rivimey/obc-drone-hat/docs/RasPi-RS232-1.png

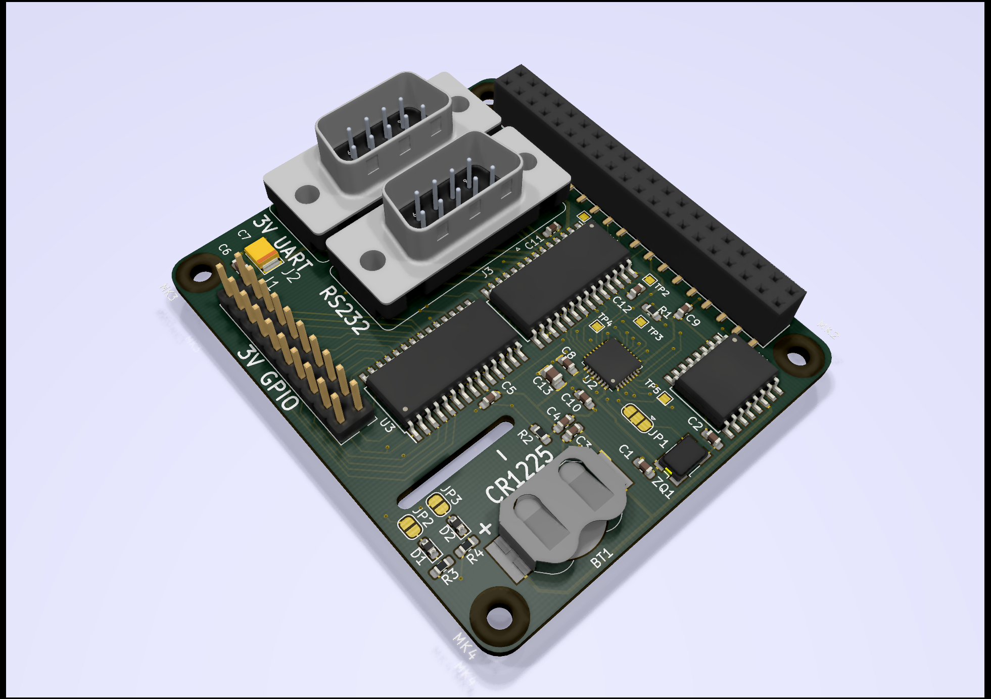
docs/RasPi-RS232-1.png
