rivimey/obc-drone-hat/docs/RasPi-RS232-3.png

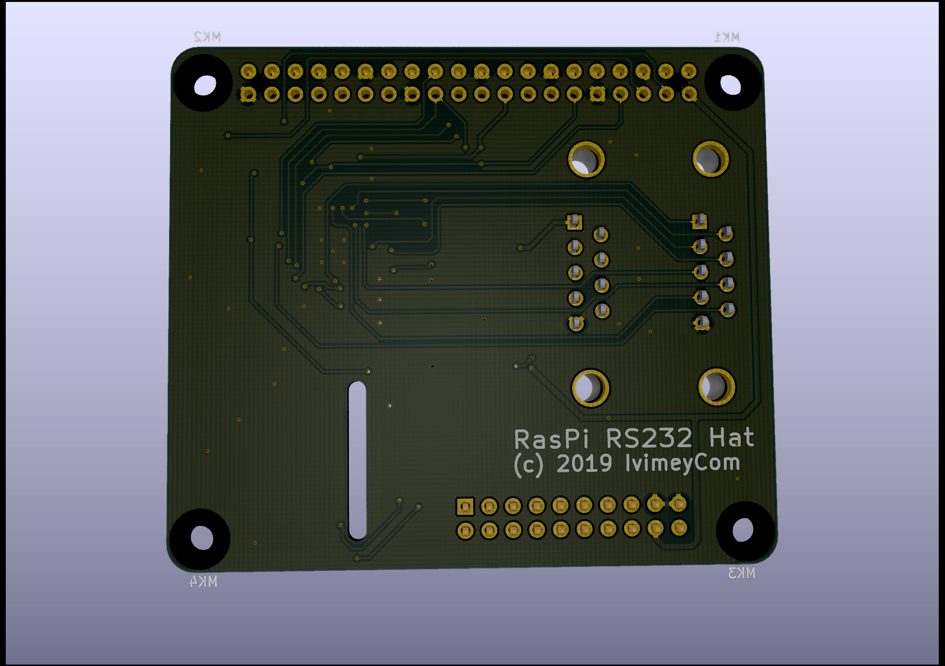
docs/RasPi-RS232-3.png
