rivimey/obc-drone-hat/docs/RasPi-RS232-2.png

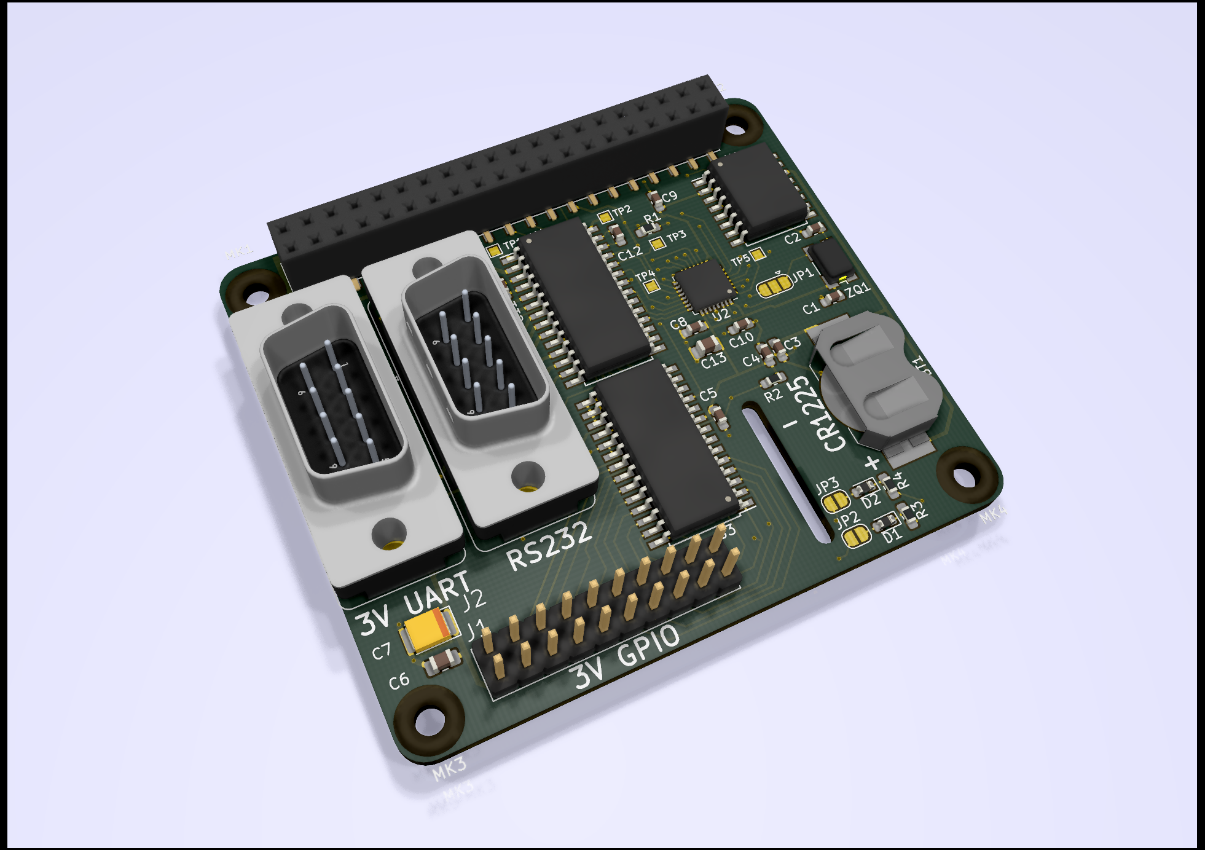
docs/RasPi-RS232-2.png
