rivimey/obc-drone-hat/docs/RasPi-RS232-4.png

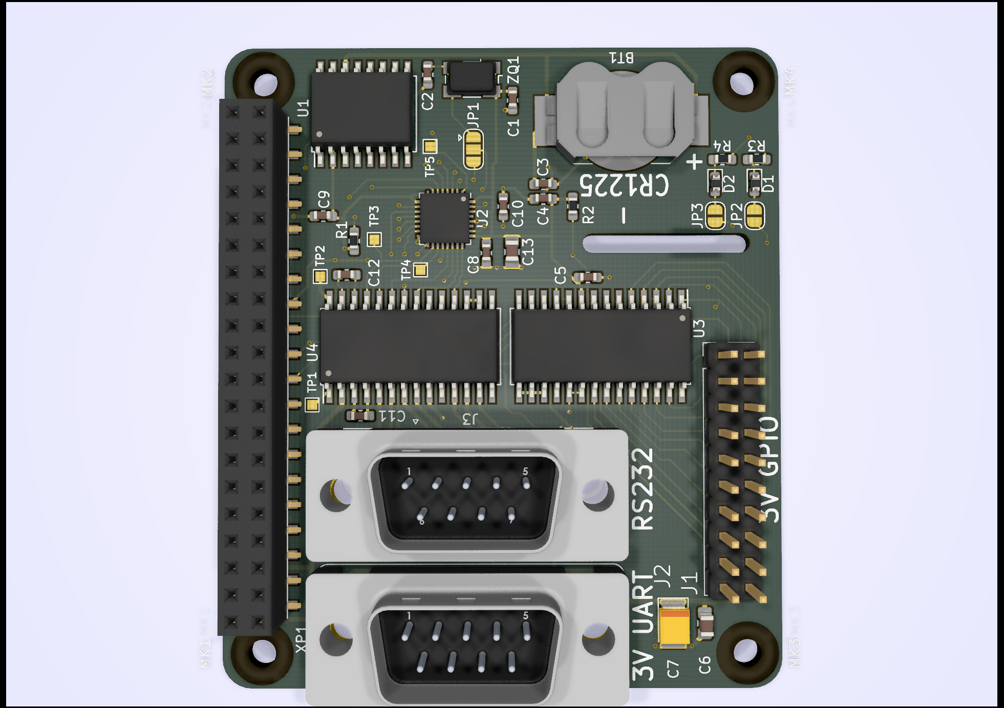
docs/RasPi-RS232-4.png
