rivimey/obc-drone-hat/docs/RaspPiSerial-3D.png

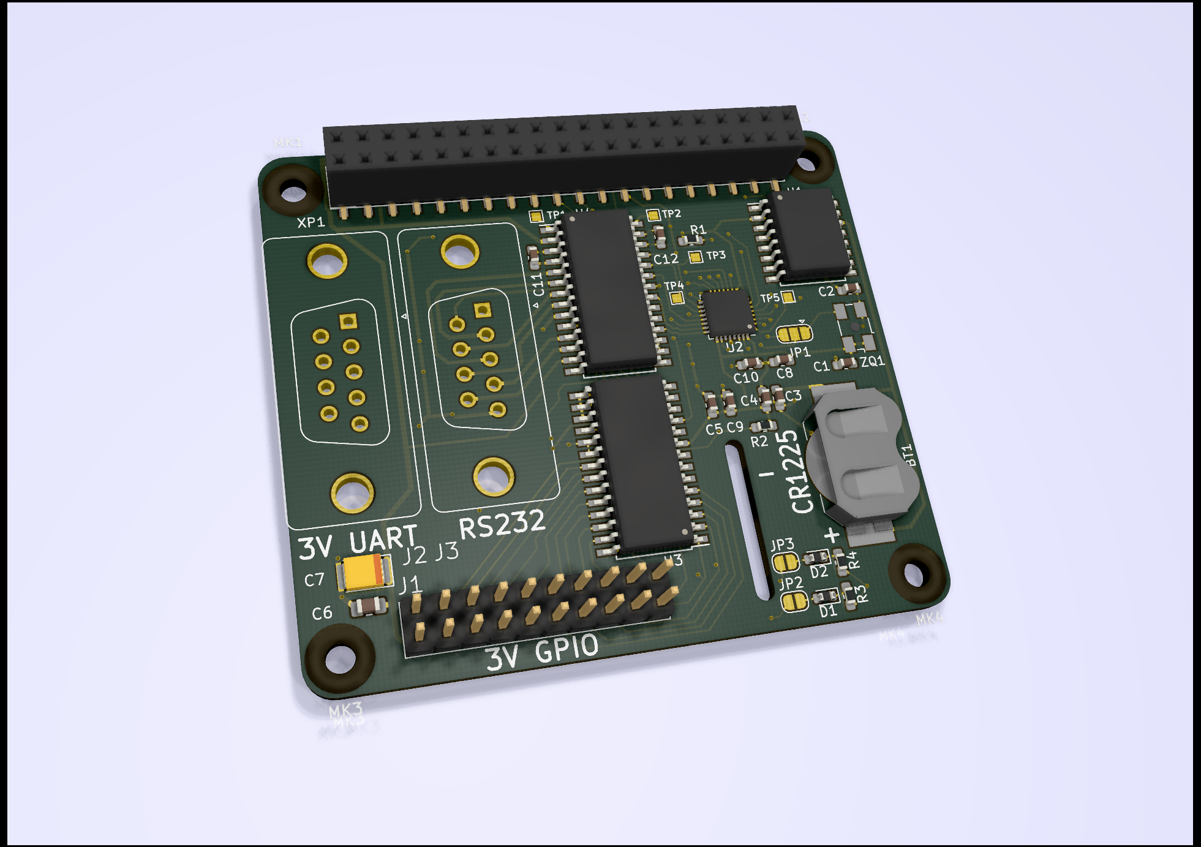
docs/RaspPiSerial-3D.png
