rivimey/obc-drone-hat/hw-v3/raspi232-v3-bottom.png

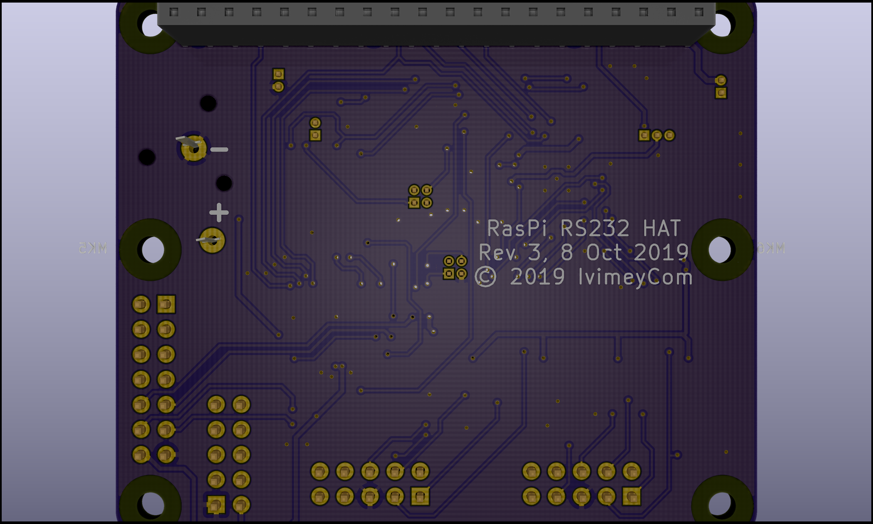
hw-v3/raspi232-v3-bottom.png
