rivimey/obc-drone-hat/hw-v3/raspi232-v3-side1.png

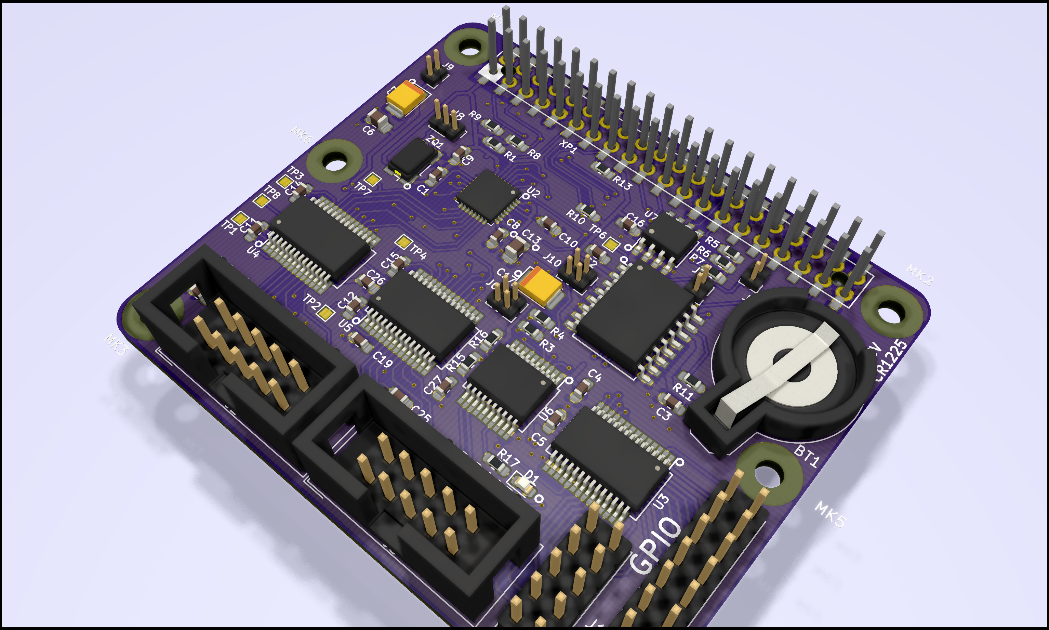
hw-v3/raspi232-v3-side1.png
