rivimey/obc-drone-hat/hw-v3/raspi232-v3-top.png

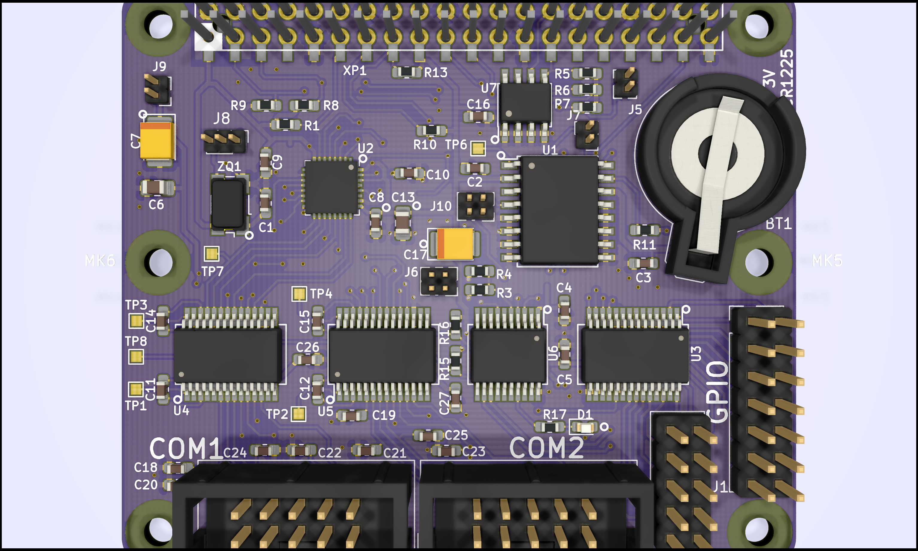
hw-v3/raspi232-v3-top.png
