rivimey/obc-drone-hat/hw-v3/digikey.xlsx

 | Label | Footprint | Datasheet | Part No | Manuf | Order No | Supplier | Unit price | Qty | Line Price | Mouser | Change
BT1 | Battery_Cell | Battery:BatteryHolder_LINX_BAT-HLD-012-SMT | https://www.mouser.co.uk/datasheet/2/238/BAT-HLD-012-SMT%20Diagram-1175215.pdf | BAT-HLD-012-SMT | Linx Technologies | BAT-HLD-012-SMT-ND | Digi-Key | £0.22 | 1 | £0.22 | £0.22 | £0.00
> C6, C13 | 10uF | Capacitor_SMD:C_0805_2012Metric_Pad1.15x1.40mm_HandSolder | https://www.mouser.co.uk/datasheet/2/427/vjw1bcbascomseries-223529.pdf~ | VJ0805G106KXYTW1BC | Vishay / Vitramon | 720-1854-1-ND | Digi-Key | £0.24 | 2 | £0.48 | £0.60 | -£0.12
> C7, C17 | 100uF | Capacitor_Tantalum_SMD:CP_EIA-3528-12_Kemet-T_Pad1.50x2.35mm_HandSolder | https://www.mouser.co.uk/datasheet/2/212/KEM_T2076_T52X-530-1104134.pdf | T520B107M010ATE070 | KEMET | 399-17690-1-ND | Digi-Key | £0.98 | 2 | £1.96 | £2.28 | -£0.32
> C1-C5, C8-C12, C14-C16 | 100nF | Capacitor_SMD:C_0603_1608Metric_Pad1.05x0.95mm_HandSolder | https://www.mouser.co.uk/datasheet/2/212/KEM_C1090_X7R_ESD-1103328.pdf | C0603C104K4RECTU | KEMET | 399-1096-1-ND | Digi-Key | £0.08 | 13 | £1.09 | £1.09 | £0.00
> C18-C25 | 100pF | Capacitor_SMD:C_0603_1608Metric_Pad1.05x0.95mm_HandSolder | https://www.mouser.co.uk/datasheet/2/212/KEM_C1090_X7R_ESD-1103328.pdf | 885012206077 | Wurth Electronics | 732-7995-1-ND | Digi-Key | £0.08 | 8 | £0.64 | £0.28 | £0.36
J1 | Conn_02x07 | Connector_PinHeader_2.54mm:PinHeader_2x07_P2.54mm_Vertical | ~ | 77313-818-14LF | Amphenol FCI | 609-5138-ND | Digi-Key | £0.42 | 1 | £0.42 | £0.48 | -£0.06
> J2, J3 | Conn_02x05_Odd_Even | Connector_IDC:IDC-Header_2x05_P2.54mm_Vertical | ~ | 86130105014345E1LF | Amphenol FCI | 609-6211-ND | Digi-Key | £0.34 | 2 | £0.68 | £0.69 | -£0.01
J4 | Conn_02x04 | Connector_PinHeader_2.54mm:PinHeader_2x04_P2.54mm_Vertical | ~ | 77313-818-08LF | Amphenol FCI | 609-5135-ND | Digi-Key | £0.33 | 1 | £0.33 | £0.37 | -£0.04
> J5-J7 | Conn_01x02 | Connector_PinHeader_1.27mm:PinHeader_1x02_P1.27mm_Vertical | https://www.mouser.co.uk/datasheet/2/181/M50-353-1100851.pdf | M50-3530242 | Harwin | 952-3598-ND | Digi-Key | £0.09 | 3 | £0.27 | £0.25 | £0.02
J8 | Conn_01x03 | Connector_PinHeader_1.27mm:PinHeader_1x03_P1.27mm_Vertical | https://www.mouser.co.uk/datasheet/2/181/M50-353-1100851.pdf | M50-3530342 | Harwin | 952-3599-ND | Digi-Key | £0.10 | 1 | £0.10 | £0.08 | £0.02
> R1, R3, R4, R10 | 10K | Resistor_SMD:R_0603_1608Metric_Pad1.05x0.95mm_HandSolder | ~ | CRCW060310K0JNEAC | Vishay | 541-10KGCT-ND | Digi-Key | £0.07 | 4 | £0.28 | £0.30 | -£0.02
> R5, R6, R8, R9 | 3.9K | Resistor_SMD:R_0603_1608Metric_Pad1.05x0.95mm_HandSolder | ~ | CRCW06033K90JNEA | Vishay | 541-3.9KGCT-ND | Digi-Key | £0.07 | 4 | £0.28 | £0.30 | -£0.02
R7 | 1K | Resistor_SMD:R_0603_1608Metric_Pad1.05x0.95mm_HandSolder | ~ | CRCW06031K00JNEAC | Vishay | 541-3991-6-ND | Digi-Key | £0.07 | 1 | £0.07 | £0.08 | -£0.01
U1 | DS3231 | Package_SO:SOIC-16W_7.5x10.3mm_P1.27mm | https://www.mouser.co.uk/datasheet/2/256/DS3231-1513891.pdf | DS3231S#T&R | Maxim Integrated | DS3231S#T&RCT-ND | Digi-Key | £5.89 | 1 | £5.89 | £6.00 | -£0.11
U2 | MAX3109 | Package_DFN_QFN:QFN-32-1EP_5x5mm_P0.5mm_EP3.45x3.45mm | https://www.mouser.co.uk/datasheet/2/256/MAX3109-1512529.pdf | MAX3109ETJ+ | Maxim Integrated | MAX3109ETJ+-ND | Digi-Key | £5.11 | 1 | £5.11 | £5.21 | -£0.10
U3 | MCP23S17_SS | Package_SO:SSOP-28_5.3x10.2mm_P0.65mm | http://ww1.microchip.com/downloads/en/DeviceDoc/20001952C.pdf | MCP23S17T-E/SS | Microchip Technology | MCP23S17T-E/SSCT-ND | Digi-Key | £1.02 | 1 | £1.02 | £1.03 | -£0.01
> U4, U5 | LT1137ACG | Package_SO:SSOP-28_5.3x10.2mm_P0.65mm | https://www.analog.com/media/en/technical-documentation/data-sheets/1130asfb.pdf | LT1137ACG#PBF | Analog Devices | LT1137ACG#PBF-ND | Digi-Key | £5.95 | 2 | £11.90 | £12.14 | -£0.24
U6 | MCP23009-ESS | Package_SO:SSOP-20_5.3x7.2mm_P0.65mm | http://ww1.microchip.com/downloads/en/devicedoc/20001952c.pdf | MCP23009-E/SS | Microchip Technology | MCP23009-E/SS-ND | Digi-Key | £0.87 | 1 | £0.87 | £0.88 | -£0.01
U7 | CAT24C64 | Package_SO:SOIC-8_3.9x4.9mm_P1.27mm | https://www.mouser.co.uk/datasheet/2/308/CAT24C64-D-106086.pdf | CAT24C64WI-GT3 | ON Semiconductor | CAT24C64WI-GT3CT-ND | Digi-Key | £0.16 | 1 | £0.16 | £0.00 | £0.16
XP1 | Rpi_40PIN | hat:RaspberryPi-40Pin_P2.54mm |  | 1112 | Adafruit | 1528-2203-ND | Digi-Key | £1.46 | 1 | £1.46 | £1.49 | -£0.03
ZQ1 | ASFL1-oscillator | Crystal:Crystal_SMD_Abracon_ABM3B-4Pin_5.0x3.2mm | https://www.mouser.com/ProductDetail/ABRACON/ASFL1-24000MHZ-EC-T | ASFL1-24.000MHZ-EC-T | ABRACON | 300-8252-1-ND | Digi-Key | £0.98 | 1 | £0.98 | £0.94 | £0.04
 |  |  |  |  |  |  |  |  | 52 | 34.213 | 34.722 | -£0.51
