rivimey/obc-drone-hat/hw-v3/mouser.xlsx

 | Footprint | Datasheet | Part No | Manuf | Order No | Supplier | Unit price | Qty | Line Price | Digi-Key | Change | Best Supplier | Unit price
BT1 | Battery:BatteryHolder_LINX_BAT-HLD-012-SMT | https://www.mouser.co.uk/datasheet/2/238/BAT-HLD-012-SMT%20Diagram-1175215.pdf | BAT-HLD-012-SMT | Linx Technologies | 712-BAT-HLD-012-SMT | Mouser | £0.22 | 1 | £0.22 | £0.22 | £0.00 |  |  | £0.22
> C6, C13 | Capacitor_SMD:C_0805_2012Metric_Pad1.15x1.40mm_HandSolder | https://www.mouser.co.uk/datasheet/2/427/vjw1bcbascomseries-223529.pdf~ | VJ0805G106KXYTW1BC | Vishay / Vitramon | 77-VJ805G106KXYTW1BC | Mouser | £0.30 | 2 | £0.60 | £0.48 | £0.12 | digi-key | £0.22 | £0.44
> C7, C17 | Capacitor_Tantalum_SMD:CP_EIA-3528-12_Kemet-T_Pad1.50x2.35mm_HandSolder | https://www.mouser.co.uk/datasheet/2/212/KEM_T2076_T52X-530-1104134.pdf | T520B107M010ATE070 | KEMET | 80-T520B107M10ATE070 | Mouser | £1.14 | 2 | £2.28 | £1.96 | £0.32 | digi-key | £0.98 | £1.96
> C1-C5, C8-C12, C14-C16 | Capacitor_SMD:C_0603_1608Metric_Pad1.05x0.95mm_HandSolder | https://www.mouser.co.uk/datasheet/2/212/KEM_C1090_X7R_ESD-1103328.pdf | C0603C104K4RECTU | KEMET | 80-C0603C104K4RECTU | Mouser | £0.08 | 13 | £1.09 | £1.09 | £0.00 | mouser | £0.04 | £0.47
> C18-C25 | Capacitor_SMD:C_0603_1608Metric_Pad1.05x0.95mm_HandSolder | https://www.mouser.co.uk/datasheet/2/212/KEM_C1090_X7R_ESD-1103328.pdf | 885012206077 | Wurth Electronics | 710-885012206077 | Mouser | £0.04 | 8 | £0.28 | £0.64 | -£0.36 |  |  | £0.28
J1 | Connector_PinHeader_2.54mm:PinHeader_2x07_P2.54mm_Vertical | ~ | 54102-S1007LF | Amphenol FCI | 649-54102-S1007LF | Mouser | £0.48 | 1 | £0.48 | £0.42 | £0.06 |  |  | £0.48
> J2, J3 | Connector_IDC:IDC-Header_2x05_P2.54mm_Vertical | ~ | 86130105014345E1LF | Amphenol FCI | 649-861315014345E1LF | Mouser | £0.34 | 2 | £0.69 | £0.68 | £0.01 |  |  | £0.69
J4 | Connector_PinHeader_2.54mm:PinHeader_2x04_P2.54mm_Vertical | ~ | 10129381-908003BLF | Amphenol FCI | 649-1012938190803BLF | Mouser | £0.37 | 1 | £0.37 | £0.33 | £0.04 |  |  | £0.37
> J5-J7 | Connector_PinHeader_1.27mm:PinHeader_1x02_P1.27mm_Vertical | https://www.mouser.co.uk/datasheet/2/181/M50-353-1100851.pdf | M50-3530242 | Harwin | 855-M50-3530242 | Mouser | £0.08 | 3 | £0.25 | £0.27 | -£0.02 |  |  | £0.25
J8 | Connector_PinHeader_1.27mm:PinHeader_1x03_P1.27mm_Vertical | https://www.mouser.co.uk/datasheet/2/181/M50-353-1100851.pdf | M50-3530242 | Harwin | 855-M50-3530242 | Mouser | £0.08 | 1 | £0.08 | £0.10 | -£0.02 |  |  | £0.08
> R1, R3, R4, R10 | Resistor_SMD:R_0603_1608Metric_Pad1.05x0.95mm_HandSolder | ~ | CRCW060310K0JNEAC | Vishay | 71-CRCW060310K0JNEAC | Mouser | £0.08 | 4 | £0.30 | £0.28 | £0.02 |  |  | £0.30
> R5, R6, R8, R9 | Resistor_SMD:R_0603_1608Metric_Pad1.05x0.95mm_HandSolder | ~ | CRCW06033K90JNEA | Vishay | 71-CRCW06033K90JNEA | Mouser | £0.08 | 4 | £0.30 | £0.28 | £0.02 | e14 | £0.02 | £0.07
R7 | Resistor_SMD:R_0603_1608Metric_Pad1.05x0.95mm_HandSolder | ~ | CRCW06031K00JNEAC | Vishay | 71-CRCW06031K00JNEAC | Mouser | £0.08 | 1 | £0.08 | £0.07 | £0.01 | arrow | £0.02 | £0.02
U1 | Package_SO:SOIC-16W_7.5x10.3mm_P1.27mm | https://www.mouser.co.uk/datasheet/2/256/DS3231-1513891.pdf | DS3231S#T&R | Maxim Integrated | 700-DS3231S#T&R- | Mouser | £6.00 | 1 | £6.00 | £5.89 | £0.11 | e14 a-p | £5.86 | £5.86
U2 | Package_DFN_QFN:QFN-32-1EP_5x5mm_P0.5mm_EP3.45x3.45mm | https://www.mouser.co.uk/datasheet/2/256/MAX3109-1512529.pdf | MAX3109ETJ+ | Maxim Integrated | 700-MAX3109ETJ+ | Mouser | £5.21 | 1 | £5.21 | £5.11 | £0.10 | digi-key | £5.11 | £5.11
U3 | Package_SO:SSOP-28_5.3x10.2mm_P0.65mm | http://ww1.microchip.com/downloads/en/DeviceDoc/20001952C.pdf | MCP23S17T-E/SS | Microchip Technology | 579-MCP23S17T-E/SS | Mouser | £1.03 | 1 | £1.03 | £1.02 | £0.01 | Arrow | £0.99 | £0.99
> U4, U5 | Package_SO:SSOP-28_5.3x10.2mm_P0.65mm | https://www.analog.com/media/en/technical-documentation/data-sheets/1130asfb.pdf | LT1137ACG#PBF | Analog Devices | 584-LT1137ACG#PBF | Mouser | £6.07 | 2 | £12.14 | £11.90 | £0.24 | Mouser | £6.00 | £12.00
U6 | Package_SO:SSOP-20_5.3x7.2mm_P0.65mm | http://ww1.microchip.com/downloads/en/devicedoc/20001952c.pdf | MCP23009-E/SS | Microchip Technology | 579-MCP23009-E/SS | Mouser | £0.88 | 1 | £0.88 | £0.87 | £0.01 | Arrow | £0.77 | £0.77
U7 | Package_SO:SOIC-8_3.9x4.9mm_P1.27mm | https://www.mouser.co.uk/datasheet/2/308/CAT24C64-D-106086.pdf | CAT24C64WI-GT3 | ON Semiconductor | 698-CAT24C64WI-GT3 | Mouser | £0.36 | 1 | £0.36 | £0.16 | £0.20 | Arrow | £0.15 | £0.15
XP1 | hat:RaspberryPi-40Pin_P2.54mm |  | 1112 | Adafruit | 485-1112 | Mouser | £1.49 | 1 | £1.49 | £1.46 | £0.03 |  |  | £1.49
ZQ1 | Crystal:Crystal_SMD_Abracon_ABM3B-4Pin_5.0x3.2mm | https://www.mouser.com/ProductDetail/ABRACON/ASFL1-24000MHZ-EC-T | ASFL1-24.000MHZ-EC-T | ABRACON | 815-ASFL1-24.0-EC-T | Mouser | £0.94 | 1 | £0.94 | £0.98 | -£0.04 |  |  | £0.94
 |  |  |  |  |  |  |  | 52 | 35.0845 | 34.213 | £0.87 |  |  | 32.9467
