rivimey/obc-drone-hat/hw-v3/182-009-113.STEP

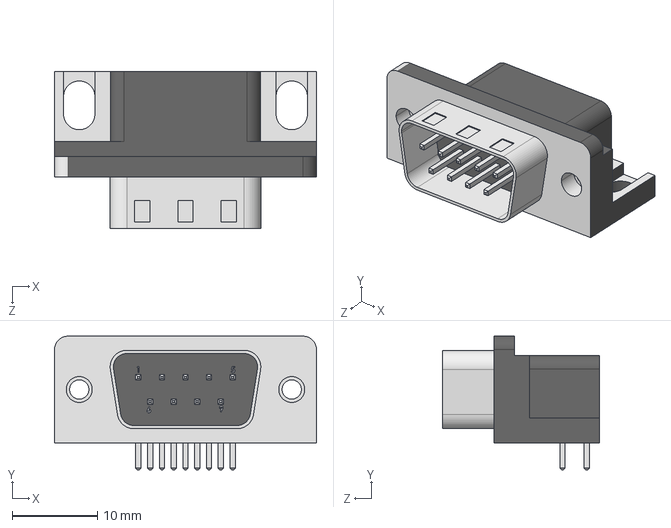
[picture p10: CAD file, 2019-03-01]
hw-v3/182-009-113.STEP
30.8 x 15.7 x 18.5 mm
