rivimey/obc-drone-hat/hw-v3/3ds/REF-182683-02.step

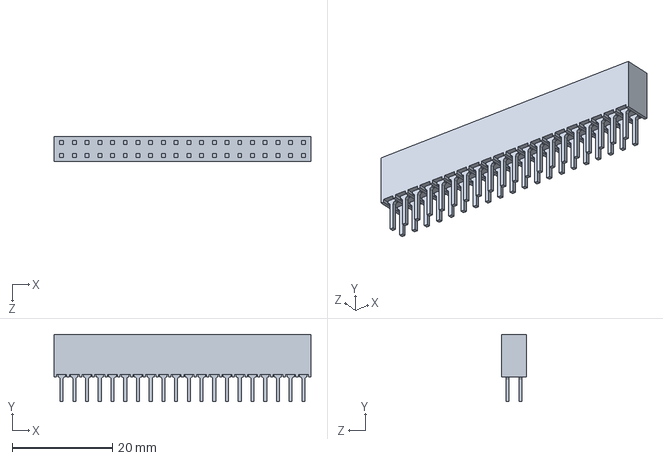
[picture p11: CAD file, 2019-03-28]
hw-v3/3ds/REF-182683-02.step
51.3 x 13.4 x 4.95 mm
