rivimey/obc-drone-hat/hw-v3/189-009-613.STEP

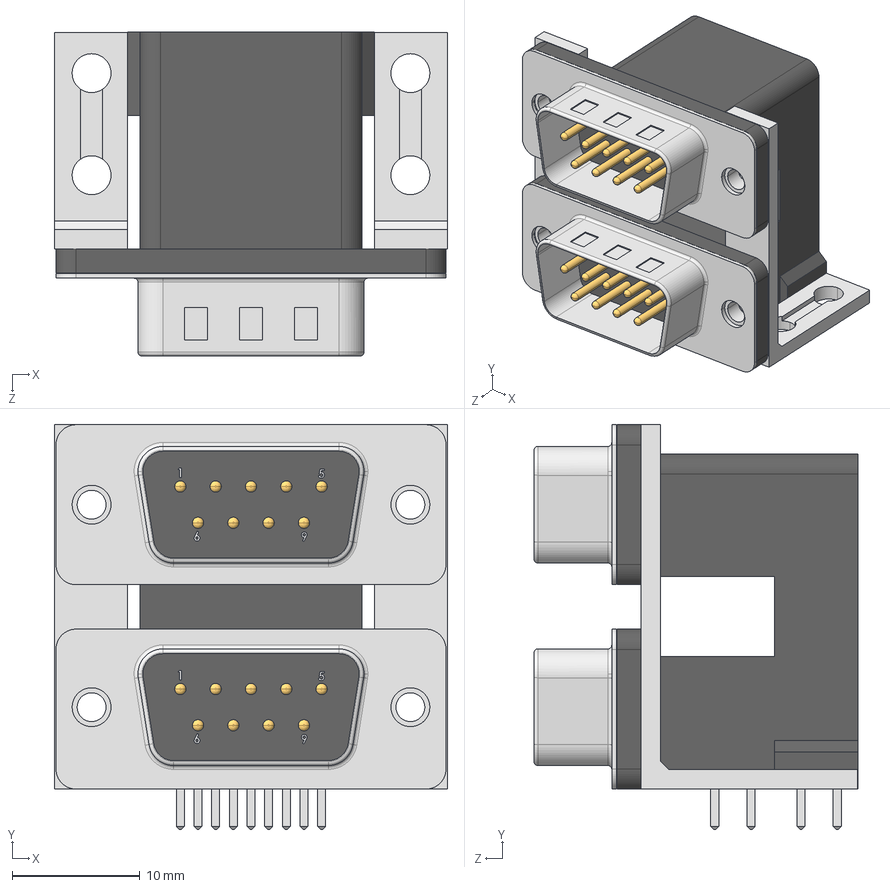
[picture p12: CAD file, 2019-03-01]
hw-v3/189-009-613.STEP
30.8 x 31.8 x 25.4 mm
