rivimey/obc-drone-hat/hw-v3/3ds/REF-182684-02-x.step

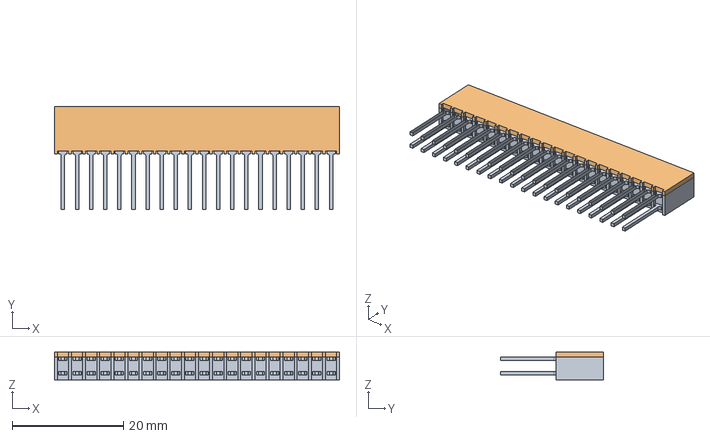
[picture p14: CAD file, 2019-03-28]
hw-v3/3ds/REF-182684-02-x.step
51.3 x 18.5 x 4.95 mm
