rivimey/obc-drone-hat/hw-v3/3ds/191-009-123.STEP

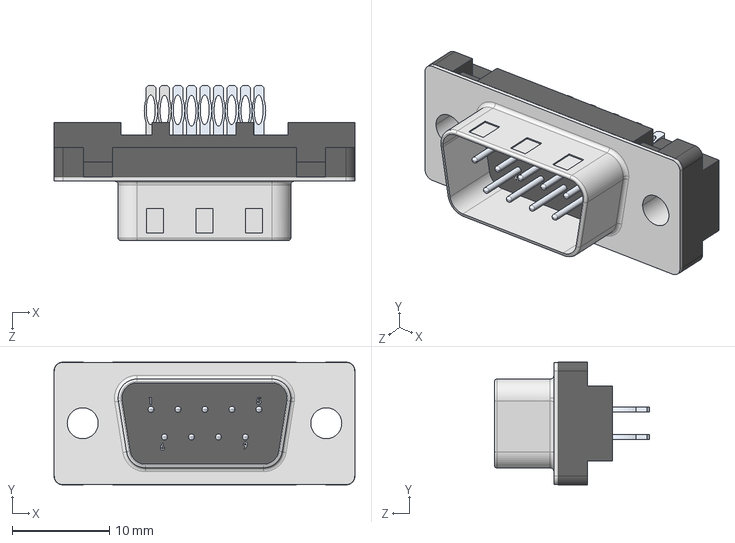
[picture p15: CAD file, 2019-03-01]
hw-v3/3ds/191-009-123.STEP
30.9 x 12.6 x 15.9 mm
