rivimey/obc-drone-hat/(list of files, cad)

Other CAD files:
hw-v3/3ds/191-009-123.IGS
