rivimey/obc-drone-hat/hw-v2/Raspi232-v3.pdf

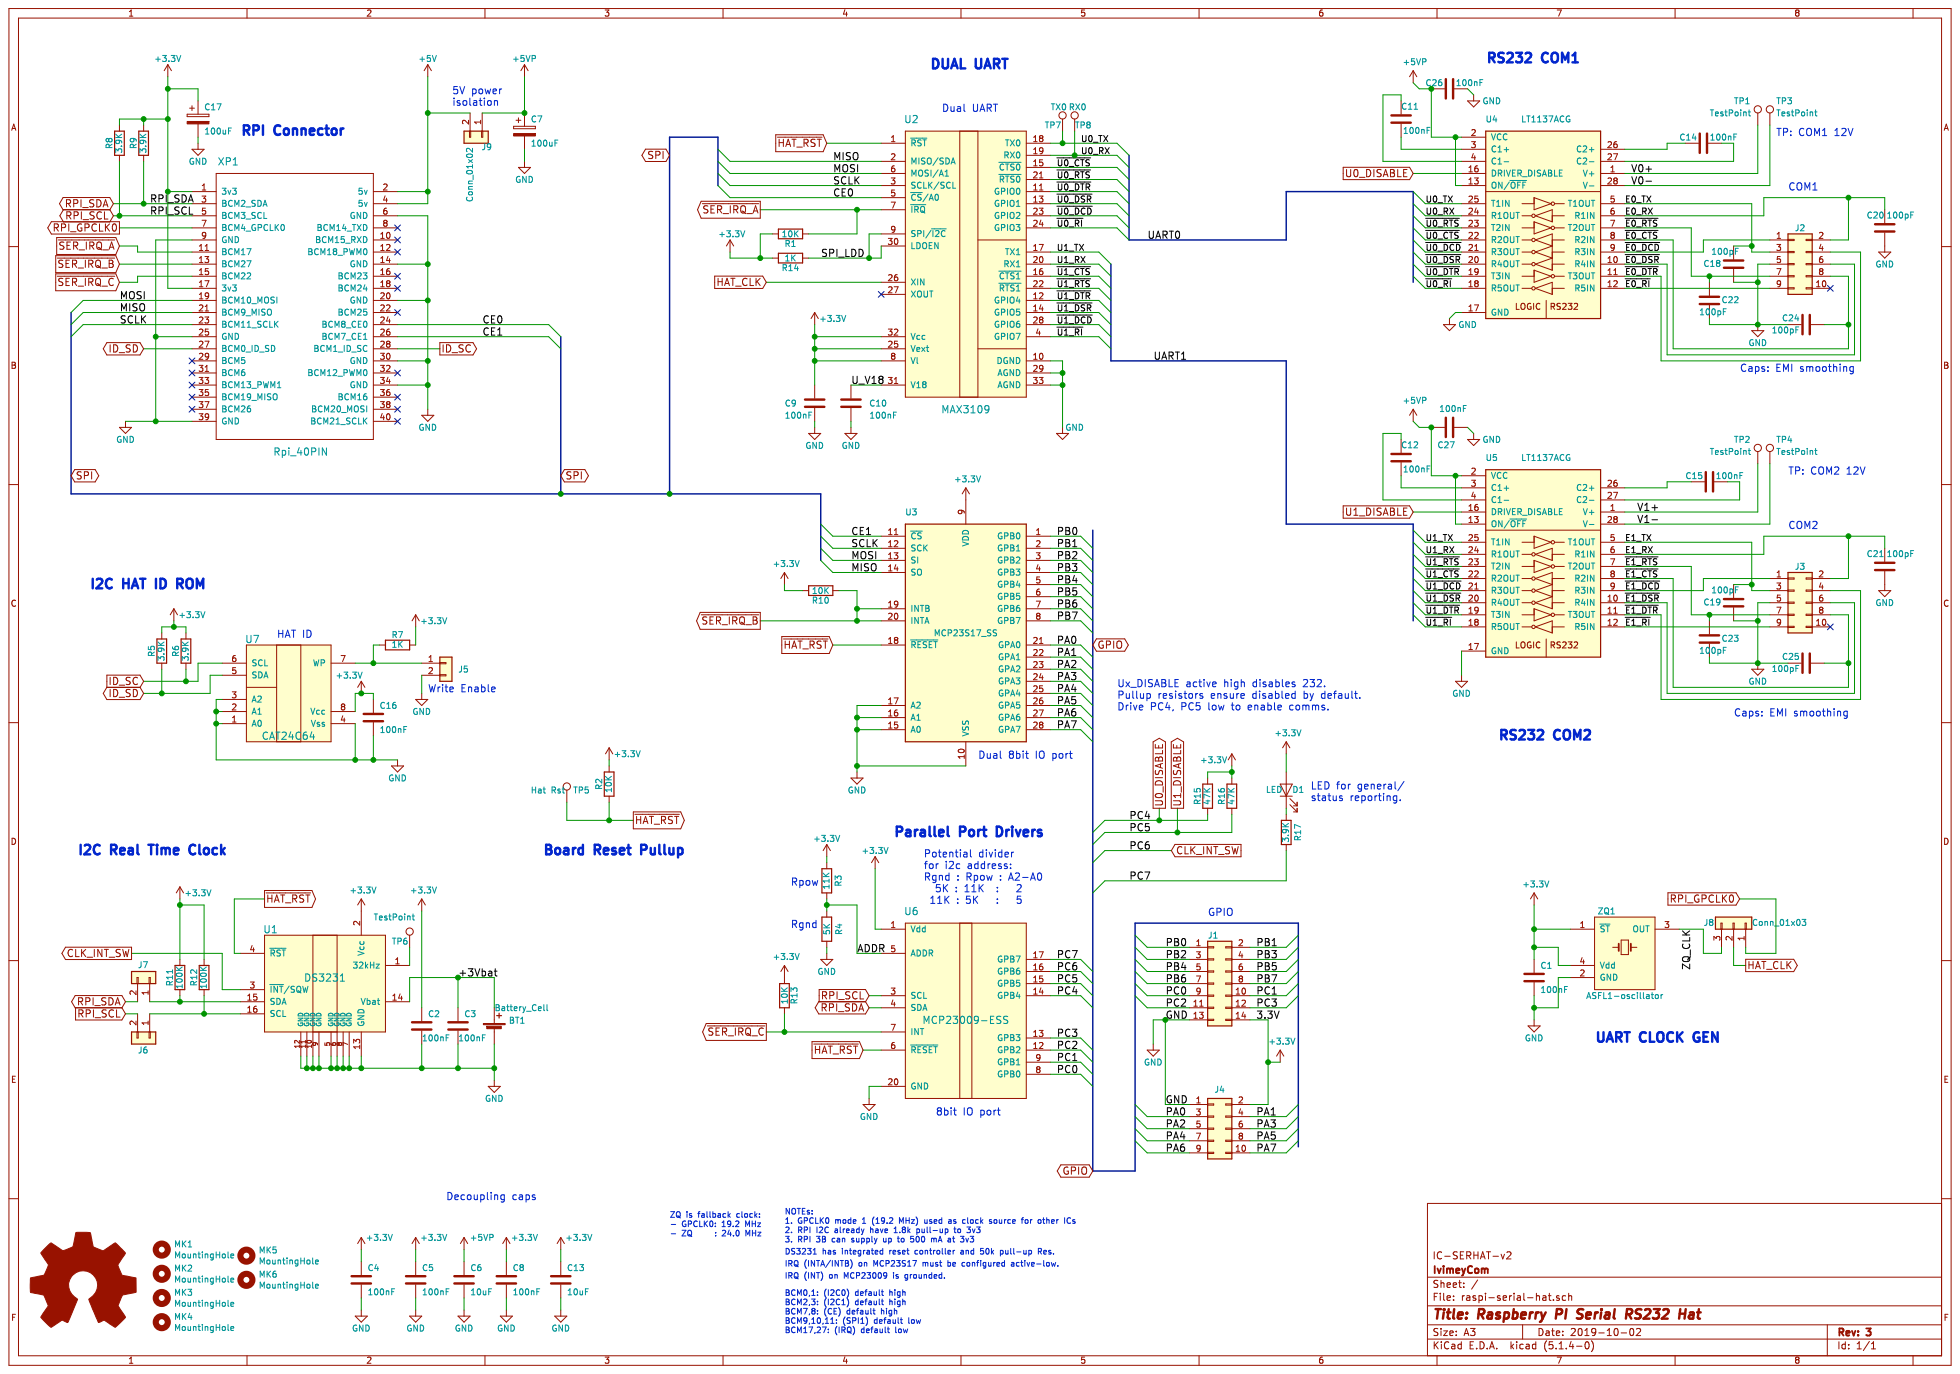
[picture p16: page 1]
