rivimey/obc-drone-hat/hw-v3/raspi-serial-hat.kicad_pcb

## KiCad design hw-v3/raspi-serial-hat.kicad_pcb (2019-11-05)

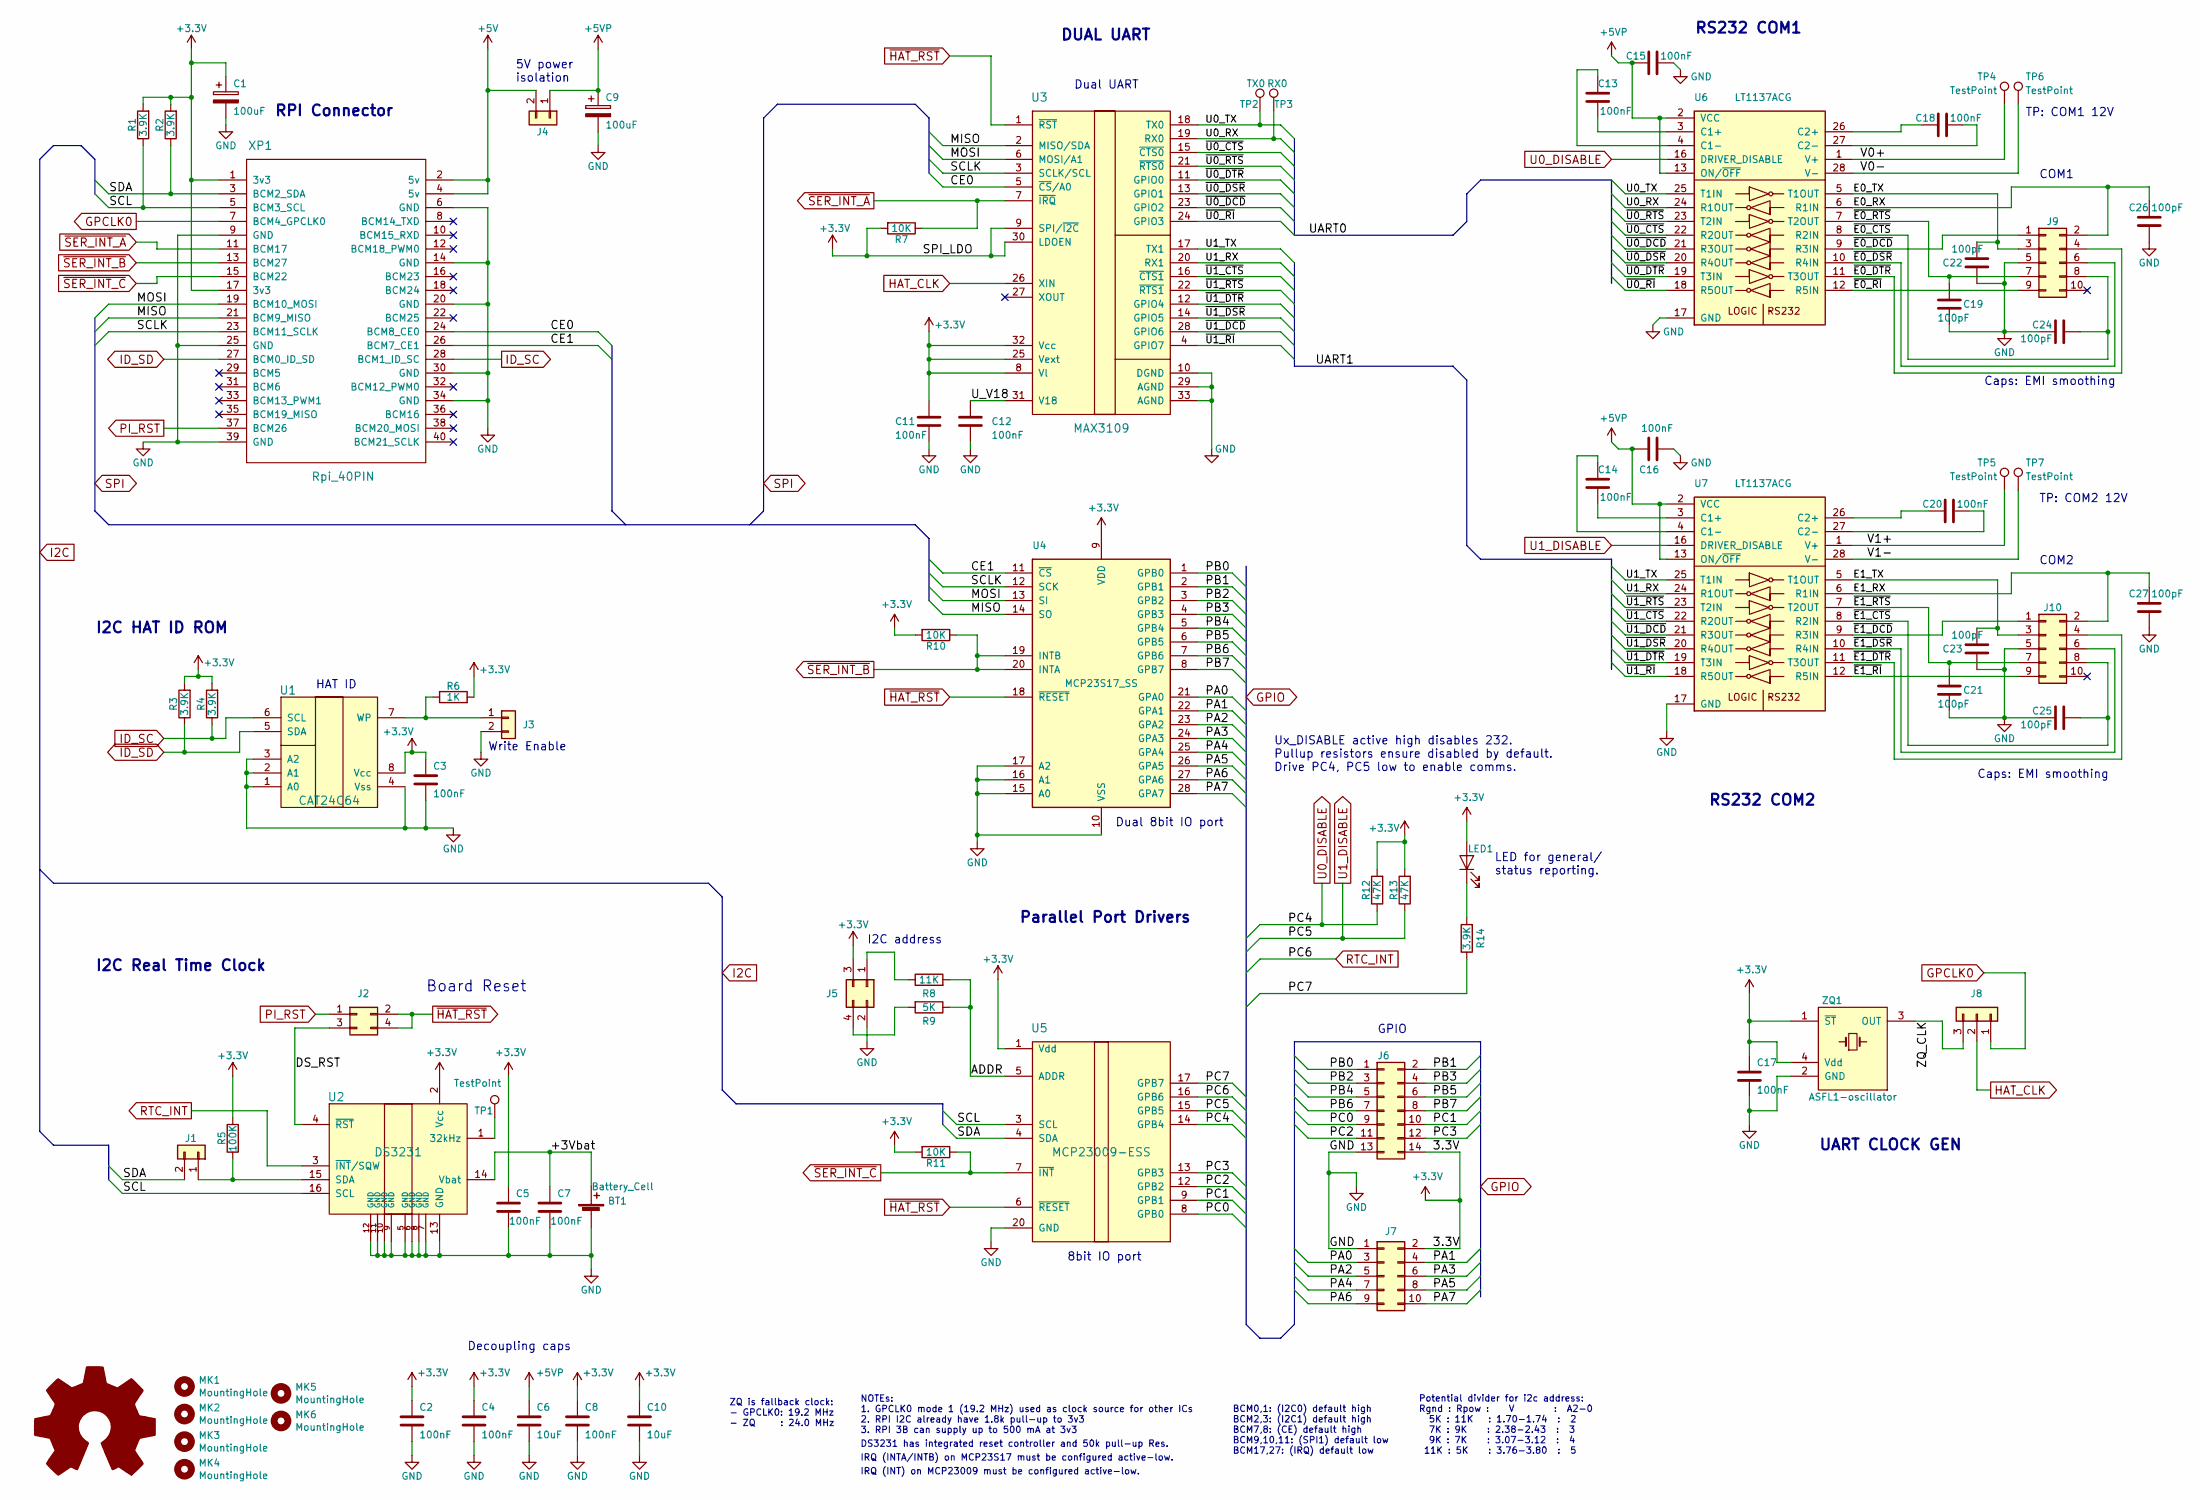
[picture p17: schematic raspi-serial-hat.sch, Raspberry PI Serial RS232 Hat]

Parts:
BT1: Battery_Cell; BatteryHolder_Keystone_500; Manuf Part No BAT-HLD-012-SMT
C1, C9: 100uF; CP_EIA-3528-12_Kemet-T_Pad1.50x2.35mm_HandSolder; Manuf Part No T520B107M010ATE070
C2, C3, C4, C5, C7, C8, C11, C12, C13, C14, C15, C16, C17, C18, C20: 100nF; C_0603_1608Metric_Pad1.05x0.95mm_HandSolder; Manuf Part No C0603C104K4RECTU
C6, C10: 10uF; C_0805_2012Metric_Pad1.15x1.40mm_HandSolder; Manuf Part No VJ0805G106KXYTW1BC
C19, C21, C22, C23, C24, C25, C26, C27: 100pF; C_0603_1608Metric_Pad1.05x0.95mm_HandSolder; Manuf Part No 885012206077
J1, J3, J4: Conn_01x02; PinHeader_1x02_P1.27mm_Vertical; Manuf Part No M50-3530242
J2, J5: Conn_02x02; PinHeader_2x02_P1.27mm_Vertical; Manuf Part No M50-3530242
J6: Conn_02x07; PinHeader_2x07_P2.54mm_Vertical; Manuf Part No 54102-S1007LF
J7: Conn_02x05_Odd_Even; PinHeader_2x05_P2.54mm_Vertical
J8: Conn_01x03; PinHeader_1x03_P1.27mm_Vertical; Manuf Part No M50-3530242
J9, J10: Conn_02x05_Odd_Even; IDC-Header_2x05_P2.54mm_Vertical; Manuf Part No 86130105014345E1LF
LED1: LED; LED_0603_1608Metric; Manuf Part No APT1608QGW
MK1, MK2, MK3, MK4, MK5, MK6: MountingHole; M2.5_Mounting_Hole
R1, R2, R3, R4, R14: 3.9K; R_0603_1608Metric_Pad1.05x0.95mm_HandSolder; Manuf Part No CRCW060310K0JNEAC
R5: 100K; R_0603_1608Metric_Pad1.05x0.95mm_HandSolder; Manuf Part No CRCW060310K0JNEAC
R6: 1K; R_0603_1608Metric_Pad1.05x0.95mm_HandSolder; Manuf Part No CRCW060310K0JNEAC
R7, R10, R11: 10K; R_0603_1608Metric_Pad1.05x0.95mm_HandSolder; Manuf Part No CRCW060310K0JNEAC
R8: 11K; R_0603_1608Metric_Pad1.05x0.95mm_HandSolder; Manuf Part No CRCW060310K0JNEAC
R9: 5K; R_0603_1608Metric_Pad1.05x0.95mm_HandSolder; Manuf Part No CRCW060310K0JNEAC
R12, R13: 47K; R_0603_1608Metric_Pad1.05x0.95mm_HandSolder; Manuf Part No CRCW060310K0JNEAC
TP1, TP4, TP5, TP6, TP7: TestPoint; TestPoint_Pad_1.0x1.0mm
TP2: TX0; TestPoint_Pad_1.0x1.0mm
TP3: RX0; TestPoint_Pad_1.0x1.0mm
U1: CAT24C64; SOIC-8_3.9x4.9mm_P1.27mm; Manuf Part No CAT24C64WI-GT3
U2: DS3231; SOIC-16W_7.5x10.3mm_P1.27mm; Manuf Part No DS3231S#T&R
U3: MAX3109; QFN-32-1EP_5x5mm_P0.5mm_EP3.45x3.45mm; Manuf Part No MAX3109ETJ+
U4: MCP23S17_SS; SSOP-28_5.3x10.2mm_P0.65mm; Manuf Part No MCP23S17T-E/SS
U5: MCP23009-ESS; SSOP-20_5.3x7.2mm_P0.65mm; Manuf Part No MCP23009-E/SS
U6, U7: LT1137ACG; SSOP-28_5.3x10.2mm_P0.65mm; Manuf Part No LT1137ACG#PBF
XP1: Rpi_40PIN; RaspberryPi-40Pin_P2.54mm; Manuf Part No 1112
ZQ1: ASFL1-oscillator; Crystal_SMD_Abracon_ABM3B-4Pin_5.0x3.2mm; Manuf Part No ASFL1-24.000MHZ-EC-T

Connections:
+3V3: C1.1, C2.1, C3.1, C4.1, C5.1, C8.1, C10.1, C11.1, C17.1, J5.3, J6.14, J7.2, LED1.2 (A), R1.2, R2.2, R3.2, R4.2, R5.2, R6.2, R7.2, R10.2, R11.2, R12.2, R13.2, U1.8 (Vcc), U2.2 (Vcc), U3.8 (Vl), U3.9 (SPI/~I2C), U3.25 (Vext), U3.30 (LDOEN), U3.32 (Vcc), U4.9 (VDD), U5.1 (Vdd), XP1.1 (3v3), XP1.17 (3v3), ZQ1.1 (~ST), ZQ1.4 (Vdd)
+5V: J4.2, XP1.2 (5v), XP1.4 (5v)
+5VP: C6.1, C9.1, C15.2, C16.1, J4.1, U6.2 (VCC), U6.13 (ON/~OFF), U7.2 (VCC), U7.13 (ON/~OFF)
/+3Vbat: BT1.1 (+), C7.1, U2.14 (Vbat)
/ADDR: R8.2, R9.1, U5.5 (ADDR)
/CE0: U3.5 (~CS~/A0), XP1.24 (BCM8_CE0)
/CE1: U4.11 (~CS~), XP1.26 (BCM7_CE1)
/DS_RST: J2.3, U2.4 (~RST)
/E0_RX: C26.2, J9.2, U6.6 (R1IN)
/E0_TX: C22.2, J9.3, U6.5 (T1OUT)
/E1_RX: C27.2, J10.2, U7.6 (R1IN)
/E1_TX: C23.2, J10.3, U7.5 (T1OUT)
/MISO: U3.2 (MISO/SDA), U4.14 (SO), XP1.21 (BCM9_MISO)
/MOSI: U3.6 (MOSI/A1), U4.13 (SI), XP1.19 (BCM10_MOSI)
/PA0: J7.3, U4.21 (GPA0)
/PA1: J7.4, U4.22 (GPA1)
/PA2: J7.5, U4.23 (GPA2)
/PA3: J7.6, U4.24 (GPA3)
/PA4: J7.7, U4.25 (GPA4)
/PA5: J7.8, U4.26 (GPA5)
/PA6: J7.9, U4.27 (GPA6)
/PA7: J7.10, U4.28 (GPA7)
/PB0: J6.1, U4.1 (GPB0)
/PB1: J6.2, U4.2 (GPB1)
/PB2: J6.3, U4.3 (GPB2)
/PB3: J6.4, U4.4 (GPB3)
/PB4: J6.5, U4.5 (GPB4)
/PB5: J6.6, U4.6 (GPB5)
/PB6: J6.7, U4.7 (GPB6)
/PB7: J6.8, U4.8 (GPB7)
/PC0: J6.9, U5.8 (GPB0)
/PC1: J6.10, U5.9 (GPB1)
/PC2: J6.11, U5.12 (GPB2)
/PC3: J6.12, U5.13 (GPB3)
/PC7: R14.1, U5.17 (GPB7)
/SCL: R1.1, U2.16 (SCL), U5.3 (SCL), XP1.5 (BCM3_SCL)
/SCLK: U3.3 (SCLK/SCL), U4.12 (SCK), XP1.23 (BCM11_SCLK)
/SDA: J1.2, R2.1, U5.4 (SDA), XP1.3 (BCM2_SDA)
/U0_RX: TP3.1, U3.19 (RX0), U6.24 (R1OUT)
/U0_TX: TP2.1, U3.18 (TX0), U6.25 (T1IN)
/U1_RX: U3.20 (RX1), U7.24 (R1OUT)
/U1_TX: U3.17 (TX1), U7.25 (T1IN)
/U_V18: C12.1, U3.31 (V18)
/V0+: TP4.1, U6.1 (V+)
/V0-: TP6.1, U6.28 (V-)
/V1+: TP5.1, U7.1 (V+)
/V1-: TP7.1, U7.28 (V-)
/ZQ_CLK: J8.3, ZQ1.3 (OUT)
/~E0_CTS: C24.2, J9.8, U6.8 (R2IN)
/~E0_DCD: J9.1, U6.9 (R3IN)
/~E0_DSR: J9.6, U6.10 (R4IN)
/~E0_DTR: J9.4, U6.11 (T3OUT)
/~E0_RI: J9.9, U6.12 (R5IN)
/~E0_RTS: C19.2, J9.7, U6.7 (T2OUT)
/~E1_CTS: C25.2, J10.8, U7.8 (R2IN)
/~E1_DCD: J10.1, U7.9 (R3IN)
/~E1_DSR: J10.6, U7.10 (R4IN)
/~E1_DTR: J10.4, U7.11 (T3OUT)
/~E1_RI: J10.9, U7.12 (R5IN)
/~E1_RTS: C21.2, J10.7, U7.7 (T2OUT)
/~U0_CTS: U3.15 (~CTS0), U6.22 (R2OUT)
/~U0_DCD: U3.23 (GPIO2), U6.21 (R3OUT)
/~U0_DSR: U3.13 (GPIO1), U6.20 (R4OUT)
/~U0_DTR: U3.11 (GPIO0), U6.19 (T3IN)
/~U0_RI: U3.24 (GPIO3), U6.18 (R5OUT)
/~U0_RTS: U3.21 (~RTS0), U6.23 (T2IN)
/~U1_CTS: U3.16 (~CTS1), U7.22 (R2OUT)
/~U1_DCD: U3.28 (GPIO6), U7.21 (R3OUT)
/~U1_DSR: U3.14 (GPIO5), U7.20 (R4OUT)
/~U1_DTR: U3.12 (GPIO4), U7.19 (T3IN)
/~U1_RI: U3.4 (GPIO7), U7.18 (R5OUT)
/~U1_RTS: U3.22 (~RTS1), U7.23 (T2IN)
GND: BT1.2 (-), C1.2, C2.2, C3.2, C4.2, C5.2, C6.2, C7.2, C8.2, C9.2, C10.2, C11.2, C12.2, C15.1, C16.2, C17.2, C19.1, C21.1, C22.1, C23.1, C24.1, C25.1, C26.1, C27.1, J3.2, J5.2, J6.13, J7.1, J9.5, J10.5, U1.1 (A0), U1.2 (A1), U1.3 (A2), U1.4 (Vss), U2.5 (GND), U2.6 (GND), U2.7 (GND), U2.8 (GND), U2.9 (GND), U2.10 (GND), U2.11 (GND), U2.12 (GND), U2.13 (GND), U3.10 (DGND), U3.29 (AGND), U3.33 (AGND), U4.10 (VSS), U4.15 (A0), U4.16 (A1), U4.17 (A2), U5.20 (GND), U6.17 (GND), U7.17 (GND), XP1.6 (GND), XP1.9 (GND), XP1.14 (GND), XP1.20 (GND), XP1.25 (GND), XP1.30 (GND), XP1.34 (GND), XP1.39 (GND), ZQ1.2 (GND)
GPCLK0: J8.1, XP1.7 (BCM4_GPCLK0)
HAT_CLK: J8.2, U3.26 (XIN)
ID_SC: R4.1, U1.6 (SCL), XP1.28 (BCM1_ID_SC)
ID_SD: R3.1, U1.5 (SDA), XP1.27 (BCM0_ID_SD)
unnamed: C13.1, U6.3 (C1+)
unnamed: C13.2, U6.4 (C1-)
unnamed: C14.1, U7.3 (C1+)
unnamed: C14.2, U7.4 (C1-)
unnamed: C18.1, U6.27 (C2-)
unnamed: C18.2, U6.26 (C2+)
unnamed: C20.1, U7.27 (C2-)
unnamed: C20.2, U7.26 (C2+)
unnamed: J1.1, R5.1, U2.15 (SDA)
unnamed: J3.1, R6.1, U1.7 (WP)
unnamed: J5.1, R8.1
unnamed: J5.4, R9.2
unnamed: LED1.1 (K), R14.2
unnamed: TP1.1, U2.1 (32kHz)
PI_RST: J2.1, XP1.37 (BCM26)
RTC_INT: U2.3 (~INT~/SQW), U5.16 (GPB6)
U0_DISABLE: R12.1, U5.14 (GPB4), U6.16 (DRIVER_DISABLE)
U1_DISABLE: R13.1, U5.15 (GPB5), U7.16 (DRIVER_DISABLE)
~HAT_RST: J2.2, J2.4, U3.1 (~RST), U4.18 (~RESET~), U5.6 (~RESET)
~SER_INT_A: R7.1, U3.7 (~IRQ), XP1.11 (BCM17)
~SER_INT_B: R10.1, U4.19 (INTB), U4.20 (INTA), XP1.13 (BCM27)
~SER_INT_C: R11.1, U5.7 (~INT), XP1.15 (BCM22)

Notes on the sheet:
DS3231 has integrated reset controller and 50k pull-up Res.
NOTEs: 1. GPCLK0 mode 1 (19.2 MHz) used as clock source for other ICs 2. RPI I2C already have 1.8k pull-up to 3v3 3. RPI 3B can supply up to 500 mA at 3v3
ZQ is fallback clock: - GPCLK0: 19.2 MHz - ZQ : 24.0 MHz
HAT ID
Decoupling caps
GPIO
Dual UART
TP: COM1 12V
Dual 8bit IO port
8bit IO port
RPI Connector
IRQ (INTA/INTB) on MCP23S17 must be configured active-low.
IRQ (INT) on MCP23009 must be configured active-low.
I2C address
COM1
BCM0,1: (I2C0) default high BCM2,3: (I2C1) default high BCM7,8: (CE) default high BCM9,10,11: (SPI1) default low BCM17,27: (IRQ) default low
5V power isolation
I2C HAT ID ROM
RS232 COM1
RS232 COM2
Caps: EMI smoothing
COM2
TP: COM2 12V
UART CLOCK GEN
DUAL UART
Parallel Port Drivers
Write Enable
Board Reset
Ux_DISABLE active high disables 232. Pullup resistors ensure disabled by default. Drive PC4, PC5 low to enable comms.
LED for general/ status reporting.
I2C Real Time Clock
Potential divider for i2c address: Rgnd : Rpow : V : A2-0 5K : 11K : 1.70-1.74 : 2 7K : 9K : 2.38-2.43 : 3 9K : 7K : 3.07-3.12 : 4 11K : 5K : 3.76-3.80 : 5

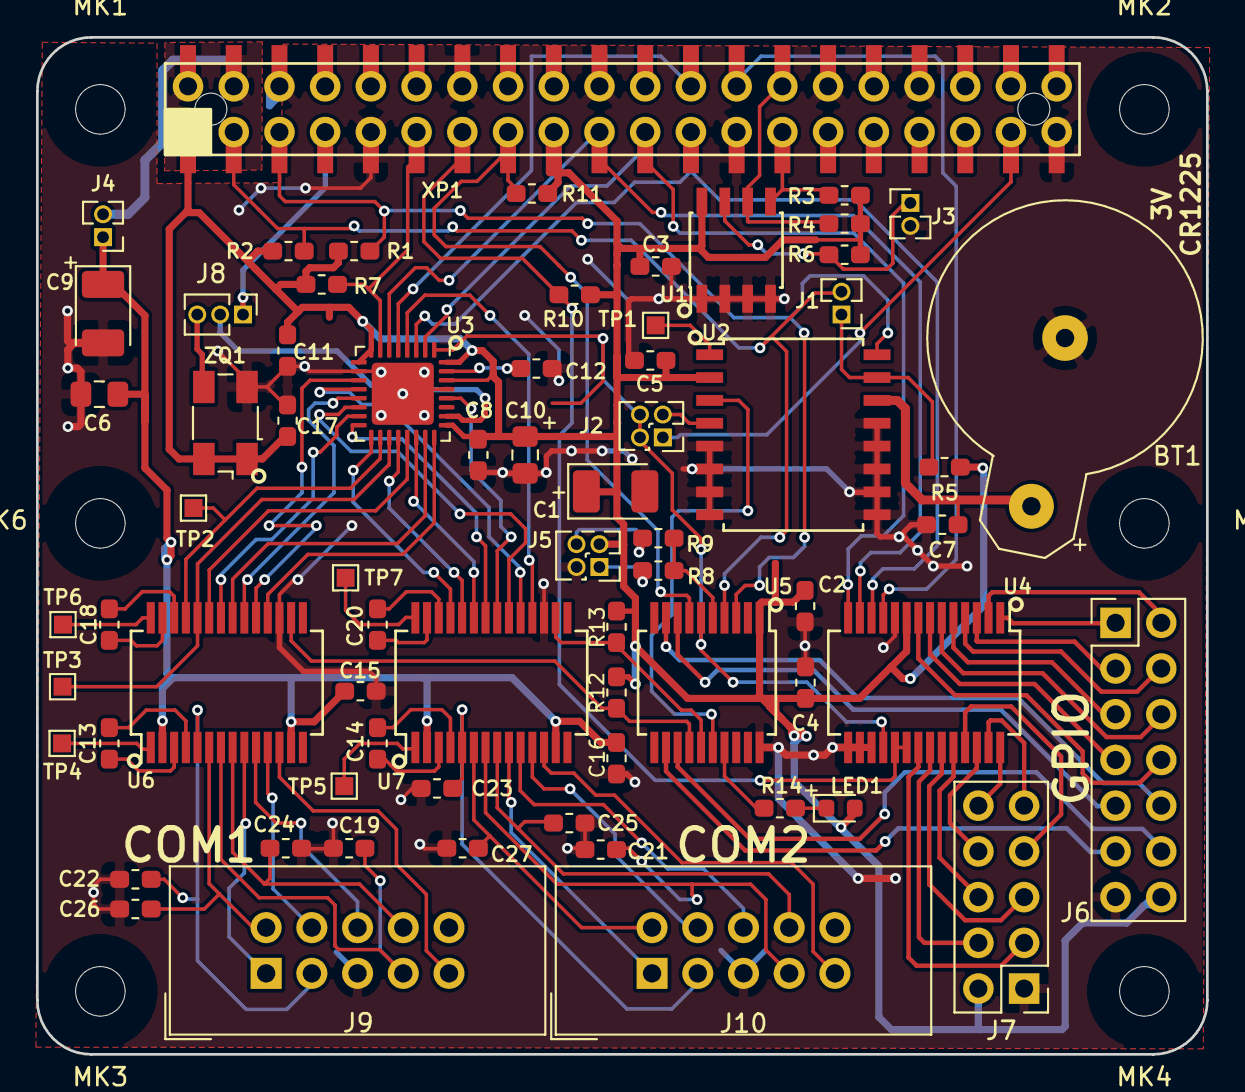
[picture p18: board hw-v3/raspi-serial-hat.kicad_pcb from above]

Board: 2 copper layers, 65.0 x 56.5 mm, 75 parts (0 on the bottom side), 99 nets.
