rivimey/obc-drone-hat/hw-v2/raspi-serial-hat.kicad_pcb

## KiCad design hw-v2/raspi-serial-hat.kicad_pcb (2019-10-09, an earlier design)

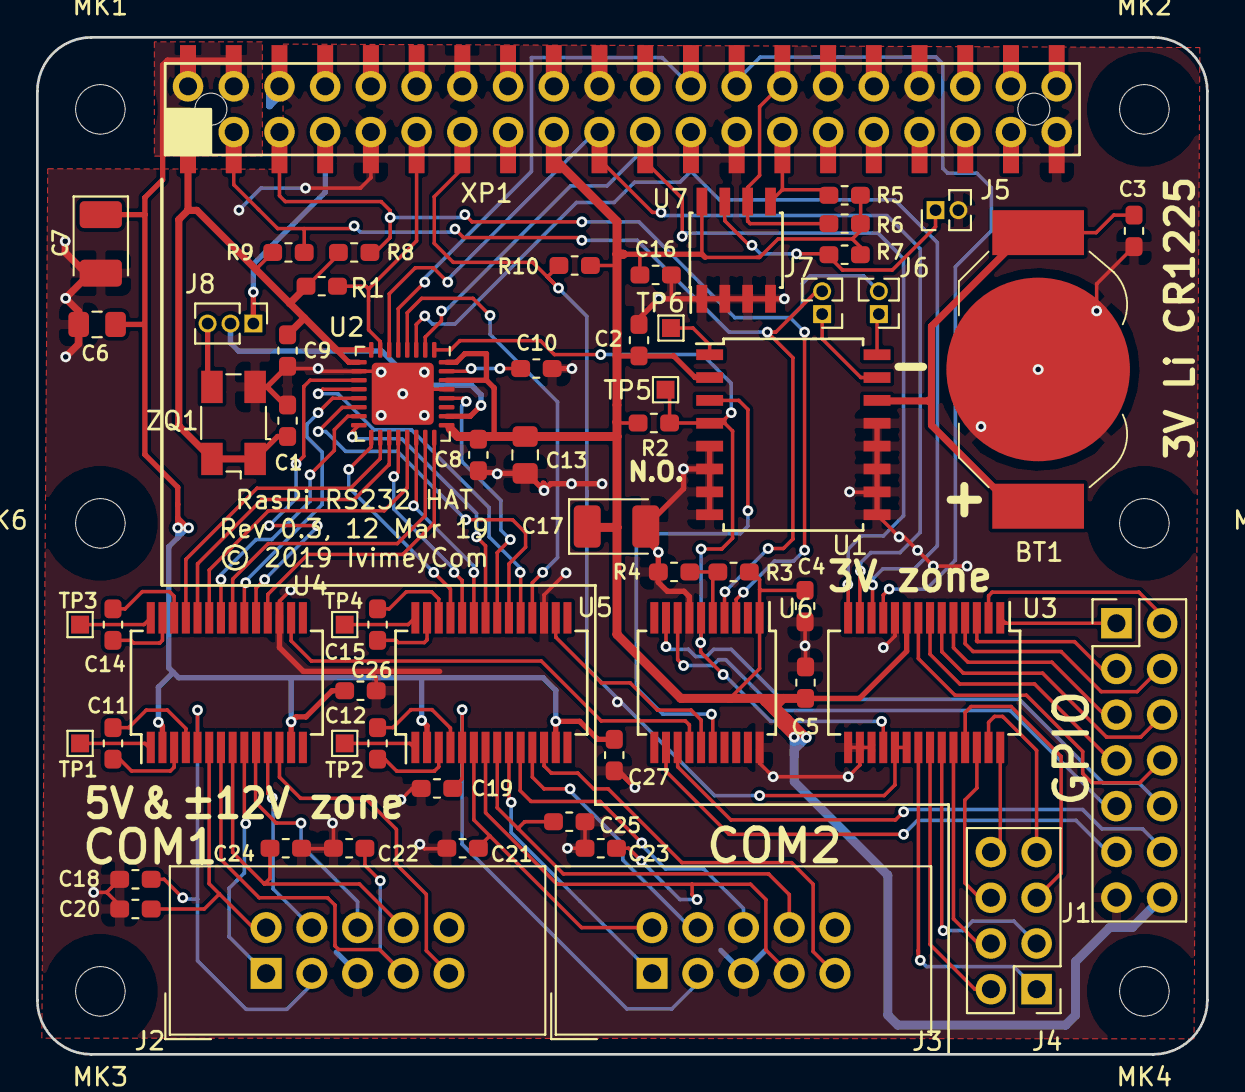
[picture p19: board hw-v2/raspi-serial-hat.kicad_pcb from above]

Board: 2 copper layers, 65.0 x 56.5 mm, 67 parts (0 on the bottom side), 92 nets.

Parts:
BT1: Battery_Cell; BatteryHolder_LINX_BAT-HLD-012-SMT
C1, C2, C3, C4, C5, C8, C9, C10, C11, C12, C14, C15, C16, C26, C27: 100nF; C_0603_1608Metric_Pad1.05x0.95mm_HandSolder
C6, C13: 10uF; C_0805_2012Metric_Pad1.15x1.40mm_HandSolder
C7, C17: 100uF; CP_EIA-3528-12_Kemet-T_Pad1.50x2.35mm_HandSolder
C18, C19, C20, C21, C22, C23, C24, C25: 100pF; C_0603_1608Metric_Pad1.05x0.95mm_HandSolder
J1: Conn_02x07; PinHeader_2x07_P2.54mm_Vertical
J2, J3: Conn_02x05_Odd_Even; IDC-Header_2x05_P2.54mm_Vertical
J4: Conn_02x04; PinHeader_2x04_P2.54mm_Vertical
J5, J6, J7: Conn_01x02; PinHeader_1x02_P1.27mm_Vertical
J8: Conn_01x03; PinHeader_1x03_P1.27mm_Vertical
MK1, MK2, MK3, MK4, MK5, MK6: MountingHole; M2.5_Mounting_Hole
R1, R3, R4, R10: 10K; R_0603_1608Metric_Pad1.05x0.95mm_HandSolder
R2: NO; R_0603_1608Metric_Pad1.05x0.95mm_HandSolder
R5, R6, R8, R9: 3.9K; R_0603_1608Metric_Pad1.05x0.95mm_HandSolder
R7: 1K; R_0603_1608Metric_Pad1.05x0.95mm_HandSolder
TP1, TP2, TP3, TP4, TP5, TP6: TestPoint; TestPoint_Pad_1.0x1.0mm
U1: DS3231; SOIC-16W_7.5x10.3mm_P1.27mm
U2: MAX3109; QFN-32-1EP_5x5mm_P0.5mm_EP3.45x3.45mm
U3: MCP23S17_SS; SSOP-28_5.3x10.2mm_P0.65mm
U4, U5: LT1137ACG; SSOP-28_5.3x10.2mm_P0.65mm
U6: MCP23009_SS; SSOP-20_5.3x7.2mm_P0.65mm
U7: CAT24C64; SOIC-8_3.9x4.9mm_P1.27mm
XP1: Rpi_40PIN; RaspberryPi-40Pin_P2.54mm
ZQ1: ASFL1-oscillator; Crystal_SMD_Abracon_ABM3B-4Pin_5.0x3.2mm

Connections:
+3V3: C1.1, C2.1, C4.1, C5.1, C8.1, C9.1, C13.1, C16.1, C17.1, J1.14, R1.2, R2.2, R3.2, R5.2, R6.2, R7.2, R8.2, R9.2, R10.2, U1.2, U2.8, U2.9, U2.25, U2.30, U2.32, U3.9, U6.1, U7.8, XP1.1, XP1.17, ZQ1.1, ZQ1.4
+5V: C6.1, C7.1, C26.1, C27.1, U4.2, U4.13, U5.2, U5.13, XP1.2, XP1.4
/+3Vbat: BT1.1, C3.1, U1.14
/CE0: U2.5, XP1.24
/CE1: U3.11, XP1.26
/E0_RX: C20.2, J2.2, U4.6
/E0_TX: C18.2, J2.3, U4.5
/E1_RX: C21.2, J3.2, U5.6
/E1_TX: C19.2, J3.3, U5.5
/MISO: U2.2, U3.14, XP1.21
/MOSI: U2.6, U3.13, XP1.19
/PA0: J4.1, U3.21
/PA1: J4.2, U3.22
/PA2: J4.3, U3.23
/PA3: J4.4, U3.24
/PA4: J4.5, U3.25
/PA5: J4.6, U3.26
/PA6: J4.7, U3.27
/PA7: J4.8, U3.28
/PB0: J1.1, U3.1
/PB1: J1.2, U3.2
/PB2: J1.3, U3.3
/PB3: J1.4, U3.4
/PB4: J1.5, U3.5
/PB5: J1.6, U3.6
/PB6: J1.7, U3.7
/PB7: J1.8, U3.8
/PC0: J1.9, U6.8
/PC1: J1.10, U6.9
/PC2: J1.11, U6.12
/PC3: J1.12, U6.13
/SCLK: U2.3, U3.12, XP1.23
/U0_RX: U2.19, U4.24
/U0_TX: U2.18, U4.25
/U1_RX: U2.20, U5.24
/U1_TX: U2.17, U5.25
/U_V18: C10.1, U2.31
/V0+: TP1.1, U4.1
/V0-: TP3.1, U4.28
/V1+: TP2.1, U5.1
/V1-: TP4.1, U5.28
/ZQ_CLK: J8.3, ZQ1.3
/~E0_CTS: C24.2, J2.8, U4.8
/~E0_DCD: J2.1, U4.9
/~E0_DSR: J2.6, U4.10
/~E0_DTR: J2.4, U4.11
/~E0_RI: J2.9, U4.12
/~E0_RTS: C22.2, J2.7, U4.7
/~E1_CTS: C25.2, J3.8, U5.8
/~E1_DCD: J3.1, U5.9
/~E1_DSR: J3.6, U5.10
/~E1_DTR: J3.4, U5.11
/~E1_RI: J3.9, U5.12
/~E1_RTS: C23.2, J3.7, U5.7
/~U0_CTS: U2.15, U4.22
/~U0_DCD: U2.23, U4.21
/~U0_DSR: U2.13, U4.20
/~U0_DTR: U2.11, U4.19
/~U0_RI: U2.24, U4.18
/~U0_RTS: U2.21, U4.23
/~U1_CTS: U2.16, U5.22
/~U1_DCD: U2.28, U5.21
/~U1_DSR: U2.14, U5.20
/~U1_DTR: U2.12, U5.19
/~U1_RI: U2.4, U5.18
/~U1_RTS: U2.22, U5.23
CLK_INT_SW: U1.3, U6.16
GND: BT1.2, C1.2, C2.2, C3.2, C4.2, C5.2, C6.2, C7.2, C8.2, C9.2, C10.2, C13.2, C16.2, C17.2, C18.1, C19.1, C20.1, C21.1, C22.1, C23.1, C24.1, C25.1, C26.2, C27.2, J1.13, J2.5, J3.5, J5.2, R4.1, U1.5, U1.6, U1.7, U1.8, U1.9, U1.10, U1.11, U1.12, U1.13, U2.10, U2.29, U2.33, U3.10, U3.15, U3.16, U3.17, U4.17, U5.17, U6.7, U6.20, U7.1, U7.2, U7.3, U7.4, XP1.6, XP1.9, XP1.14, XP1.20, XP1.25, XP1.30, XP1.34, XP1.39, ZQ1.2
HAT_CLK: J8.2, U2.26
ID_SC: R6.1, U7.6, XP1.28
ID_SD: R5.1, U7.5, XP1.27
unnamed: C11.1, U4.3
unnamed: C11.2, U4.4
unnamed: C12.1, U5.3
unnamed: C12.2, U5.4
unnamed: C14.1, U4.27
unnamed: C14.2, U4.26
unnamed: C15.1, U5.27
unnamed: C15.2, U5.26
unnamed: J5.1, R7.1, U7.7
unnamed: J6.1, U1.16
unnamed: J7.1, U1.15
unnamed: R3.1, R4.2, U6.5
unnamed: TP6.1, U1.1
RPI_GPCLK0: J8.1, XP1.7
RPI_SCL: J6.2, R8.1, U6.3, XP1.5
RPI_SDA: J7.2, R9.1, U6.4, XP1.3
U0_DISABLE: U4.16, U6.14
U1_DISABLE: U5.16, U6.15
~HAT_RST: R2.1, TP5.1, U1.4, U2.1, U3.18, U6.6
~SER_IRQ_A: R1.1, U2.7, XP1.11
~SER_IRQ_B: R10.1, U3.19, U3.20, XP1.13
