rivimey/obc-drone-hat/(commit log)

2019-02-19 rebuild as serio/pario hat
    [conn.sch, dc-dc.sch, obc-drone-hat.kicad_pcb, obc-drone-hat.sch, rcio-mcu.sch, rpi.sch, rtc.sch, uart.sch]
2019-03-01 prepare for v2
    [182-009-113.STEP, 189-009-613.STEP, 191-009-123.IGS, 191-009-123.STEP, conn.sch, dc-dc.sch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]
2019-03-28 board v2, using IDC cables and with config rom.
    [REF-182683-02.step, REF-182683-02.stl, REF-182684-02-x.step, REF-182684-02.step, Uart_Buffer.sch, digikey.xlsx, file5D2FCFEF.sch, mouser.xlsx]
2019-10-09 Version 3
    [182-009-113.STEP, 189-009-613.STEP, 191-009-123.IGS, 191-009-123.STEP, REF-182683-02.step, REF-182683-02.stl, REF-182684-02-x.step, REF-182684-02.step]
2019-10-09 Tidy folder
    [raspi-serial-hat.csv, raspi-serial-hat.kicad_pcb, seeed.xlsx]
2019-11-05 Create gerbers and relabel schematic
    [raspi-serial-hat-B_Cu.gbl, raspi-serial-hat-B_Mask.gbs, raspi-serial-hat-B_SilkS.gbo, raspi-serial-hat-Edge_Cuts.gm1, raspi-serial-hat-F_Cu.gtl, raspi-serial-hat-F_Mask.gts, raspi-serial-hat-F_SilkS.gto, raspi-serial-hat-bottom-pos.csv]
