rivimey/obc-drone-hat/(notices)

Notices in the files:
hw-v3/raspi-serial-hat.kicad_pcb:
© 2019 IvimeyCom
hw-v2/raspi-serial-hat-v2.kicad_pcb:
(c) 2019 IvimeyCom
